candelacerezo/BioAmp-EXG-Pill/hardware/BioAmp-EXG-Pill.kicad_sch

## KiCad design hardware/BioAmp-EXG-Pill.kicad_sch (2025-01-23)

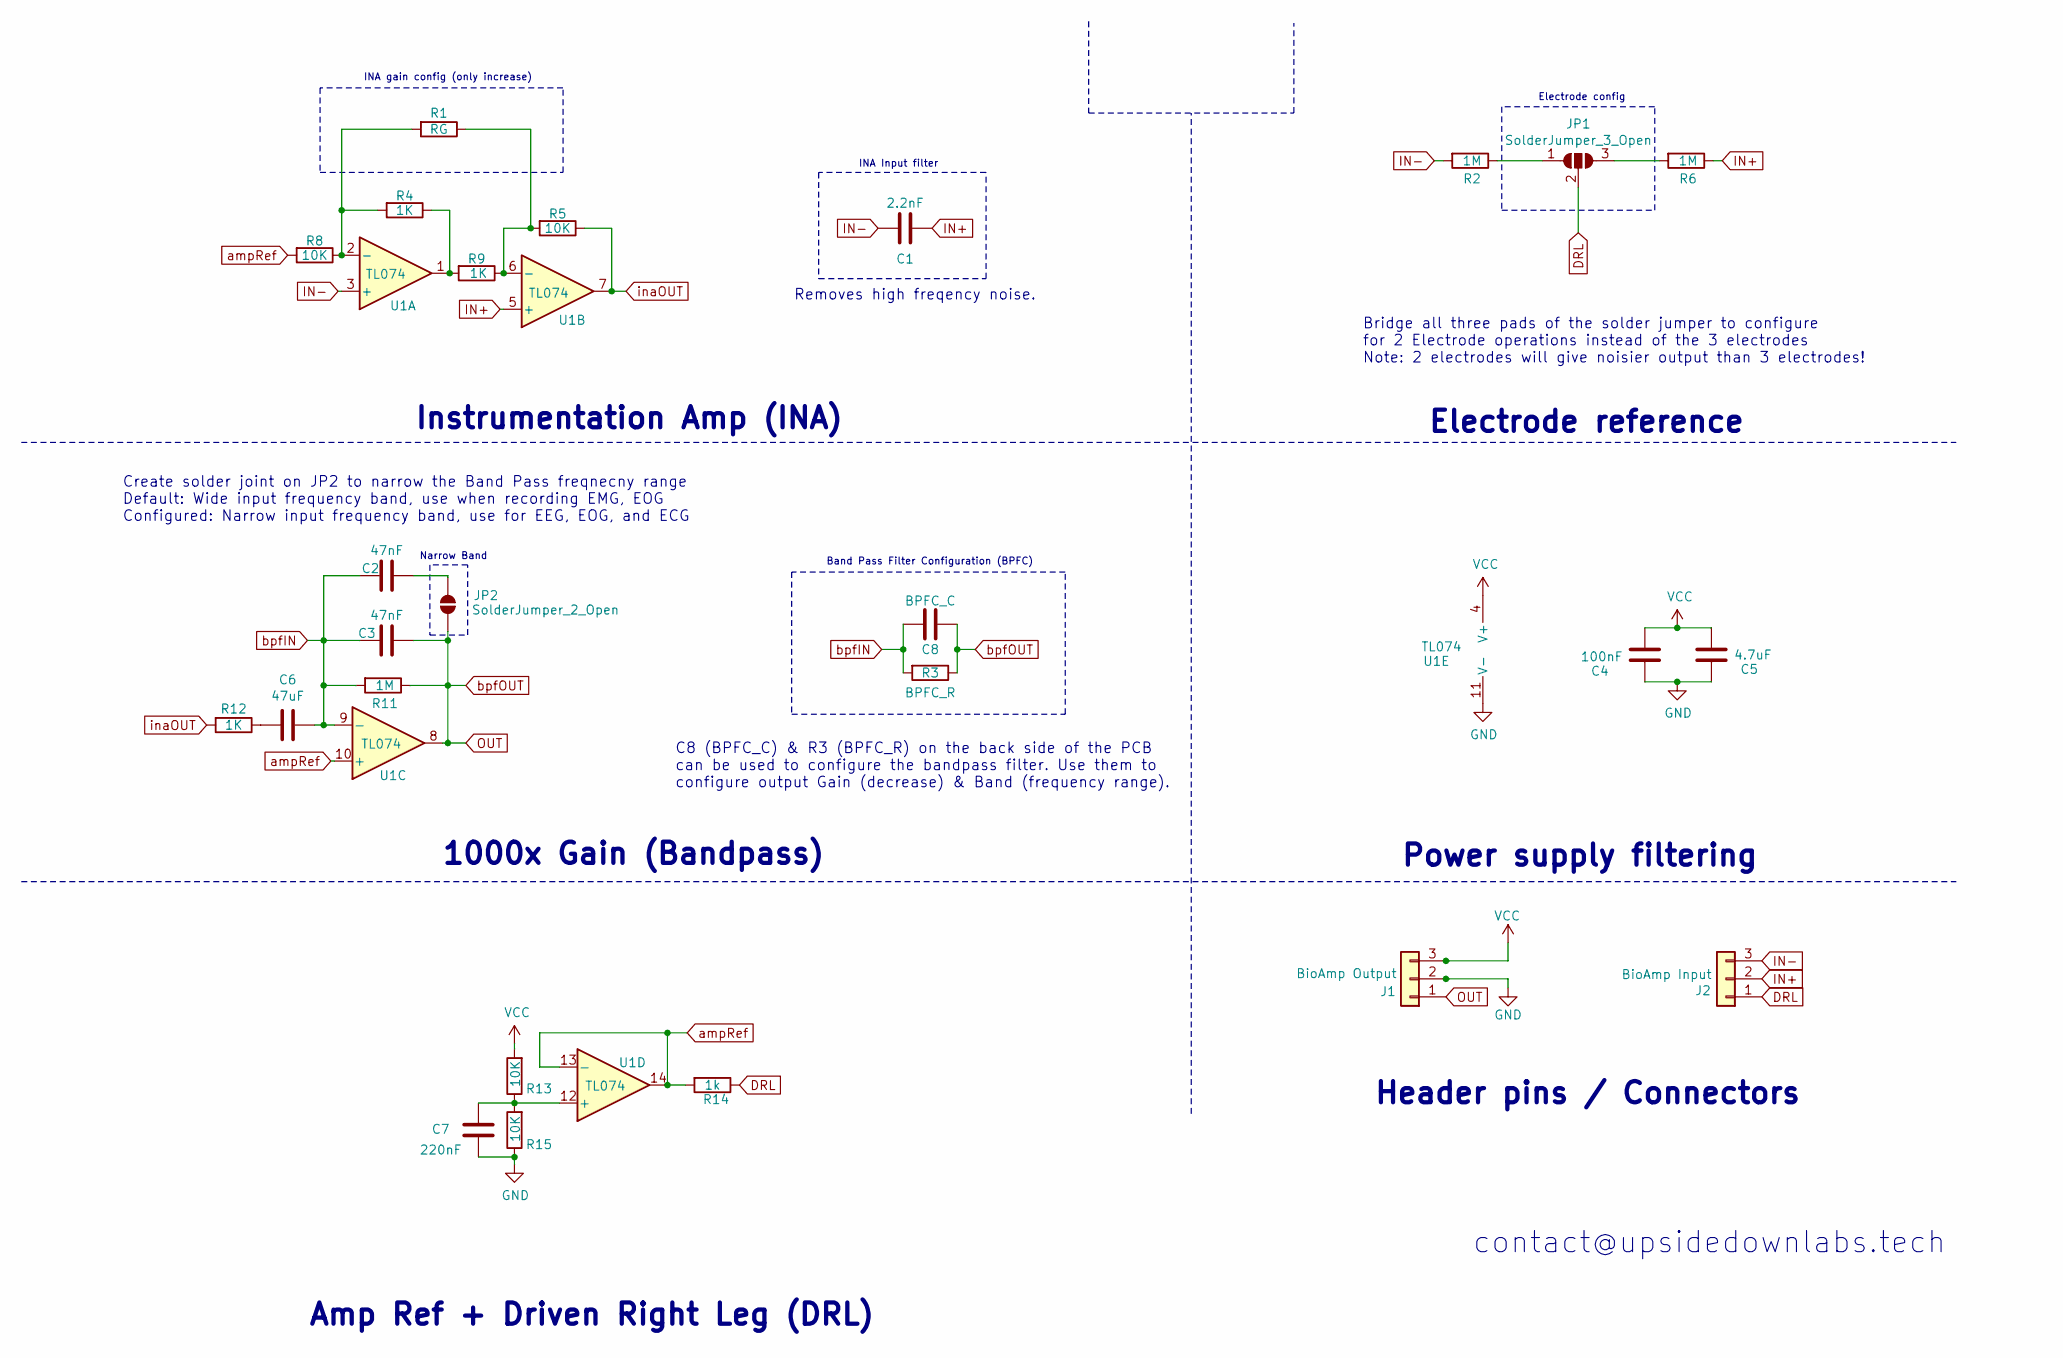
[picture p1: schematic BioAmp-EXG-Pill.kicad_sch]

Parts:
C1: 2.2nF; C_0603_1608Metric_Pad1.08x0.95mm_HandSolder
C2, C3: 47nF; C_0603_1608Metric_Pad1.08x0.95mm_HandSolder
C4: 100nF; C_0603_1608Metric_Pad1.08x0.95mm_HandSolder
C5: 4.7uF; C_0603_1608Metric_Pad1.08x0.95mm_HandSolder
C6: 47uF; C_0805_2012Metric_Pad1.18x1.45mm_HandSolder
C7: 220nF; C_0603_1608Metric_Pad1.08x0.95mm_HandSolder
C8: BPFC_C; C_0603_1608Metric_Pad1.08x0.95mm_HandSolder
J1: BioAmp Output; PinHeader_1x03_P2.54mm_Vertical
J2: BioAmp Input; PinHeader_1x03_P2.54mm_Vertical
JP1: SolderJumper_3_Open; SolderJumper-3_P1.3mm_Open_RoundedPad1.0x1.5mm
JP2: SolderJumper_2_Open; SolderJumper-2_P1.3mm_Open_RoundedPad1.0x1.5mm
R1: RG; R_0603_1608Metric_Pad0.98x0.95mm_HandSolder
R2, R6, R11: 1M; R_0603_1608Metric_Pad0.98x0.95mm_HandSolder
R3: BPFC_R; R_0603_1608Metric_Pad0.98x0.95mm_HandSolder
R4, R9, R12: 1K; R_0603_1608Metric_Pad0.98x0.95mm_HandSolder
R5, R8, R13, R15: 10K; R_0603_1608Metric_Pad0.98x0.95mm_HandSolder
R14: 1k; R_0603_1608Metric_Pad0.98x0.95mm_HandSolder
U1: TL074; TSSOP-14_4.4x5mm_P0.65mm

Connections:
DRL: J2.1, JP1.2 (C), R14.1
GND: C4.1, C5.1, C7.2, J1.2, R15.1, U1.11 (V-)
IN+: C1.1, J2.2, R6.1, U1.5 (+)
IN-: C1.2, J2.3, R2.2, U1.3 (+)
unnamed: C2.1, JP2.1 (A)
unnamed: C6.2, R12.1
unnamed: C7.1, R13.1, R15.2, U1.12 (+)
unnamed: JP1.1 (A), R2.1
unnamed: JP1.3 (B), R6.2
unnamed: R1.1, R5.2, R9.1, U1.6 (-)
unnamed: R1.2, R4.2, R8.1, U1.2 (-)
unnamed: R4.1, R9.2, U1.1
VCC: C4.2, C5.2, J1.3, R13.2, U1.4 (V+)
ampRef: R8.2, R14.2, U1.10 (+), U1.13 (-), U1.14
bpfIN: C2.2, C3.2, C6.1, C8.2, R3.2, R11.2, U1.9 (-)
bpfOUT: C3.1, C8.1, J1.1, JP2.2 (B), R3.1, R11.1, U1.8
inaOUT: R5.1, R12.2, U1.7

Notes on the sheet:
INA Input filter
Bridge all three pads of the solder jumper to configure for 2 Electrode operations instead of the 3 electrodes Note: 2 electrodes will give noisier output than 3 electrodes!
Removes high freqency noise.
Power supply filtering
Band Pass Filter Configuration (BPFC)
Electrode reference
Header pins / Connectors
INA gain config (only increase)
Instrumentation Amp (INA)
C8 (BPFC_C) & R3 (BPFC_R) on the back side of the PCB can be used to configure the bandpass filter. Use them to configure output Gain (decrease) & Band (frequency range).
1000x Gain (Bandpass)
Narrow Band
Create solder joint on JP2 to narrow the Band Pass freqnecny range Default: Wide input frequency band, use when recording EMG, EOG Configured: Narrow input frequency band, use for EEG, EOG, and ECG
contact@upsidedownlabs.tech
Amp Ref + Driven Right Leg (DRL)
Electrode config
